CodeNova-X/PicoScout1/Images/PicoScout1-img1.png

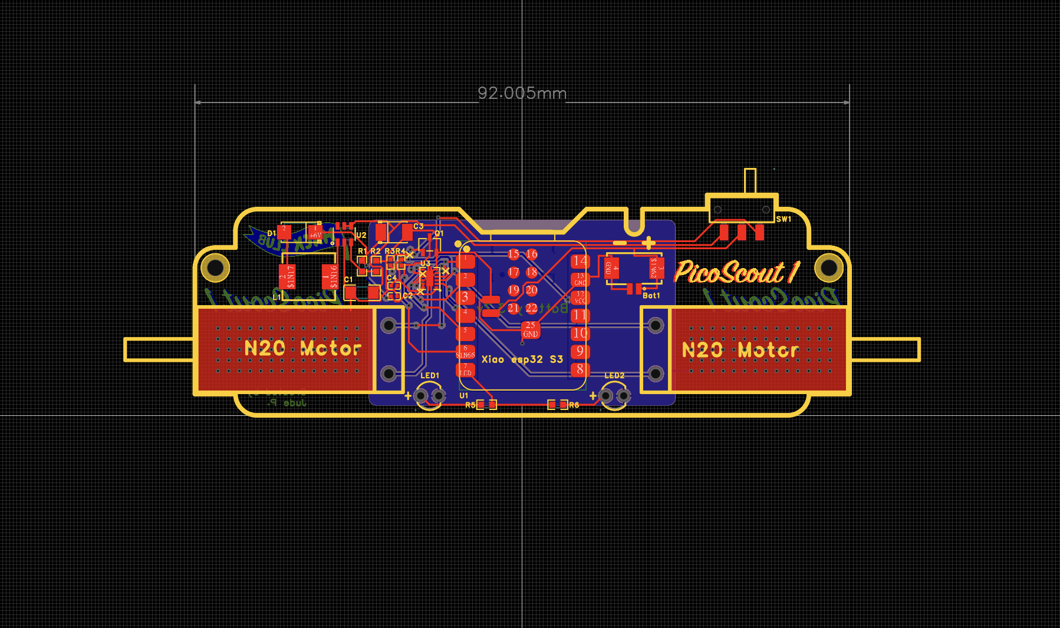
Images/PicoScout1-img1.png
