CodeNova-X/PicoScout1/Images/PicoScout1-img2.png

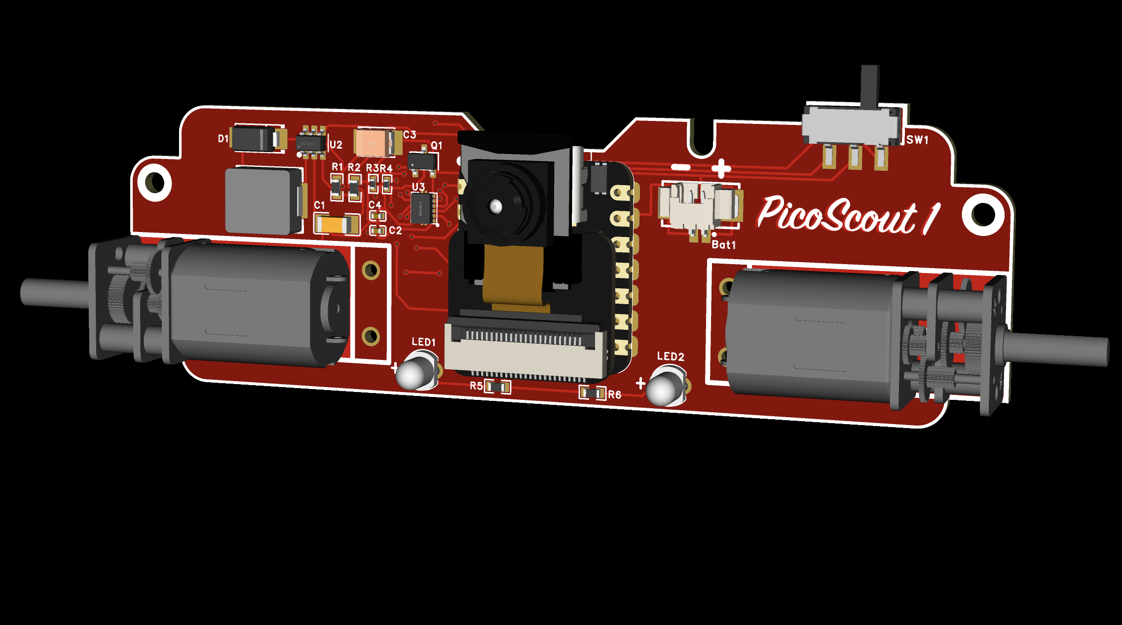
Images/PicoScout1-img2.png
