CodeNova-X/PicoScout1/Images/PicoScout1-img3.png

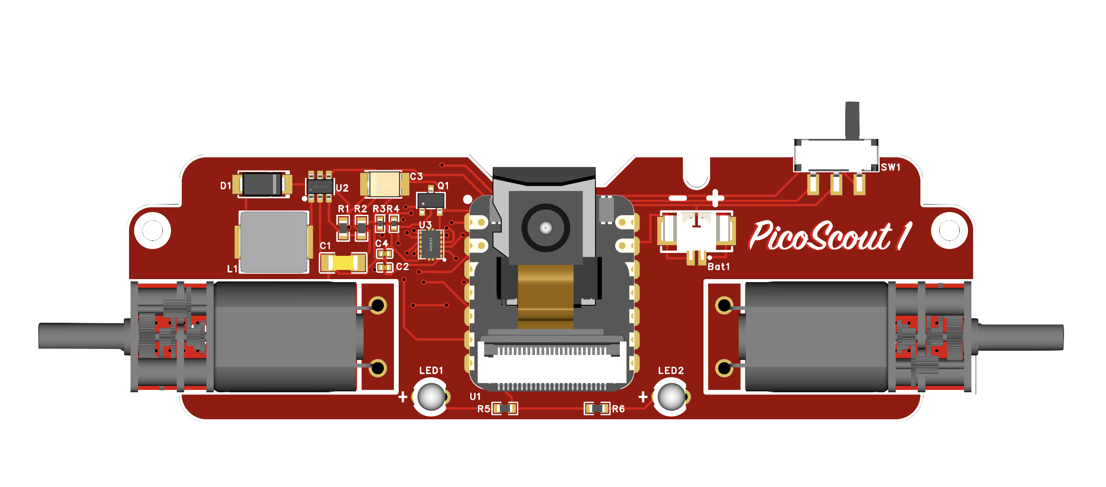
Images/PicoScout1-img3.png
