CodeNova-X/PicoScout1/Images/PicoScout1-img4.png

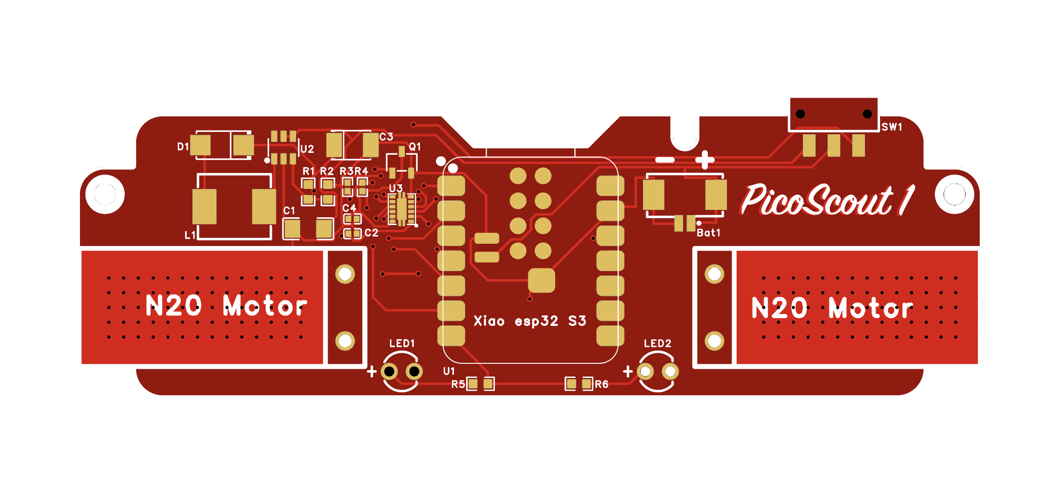
Images/PicoScout1-img4.png
