CodeNova-X/PicoScout1/Images/PicoScout1-img5.png

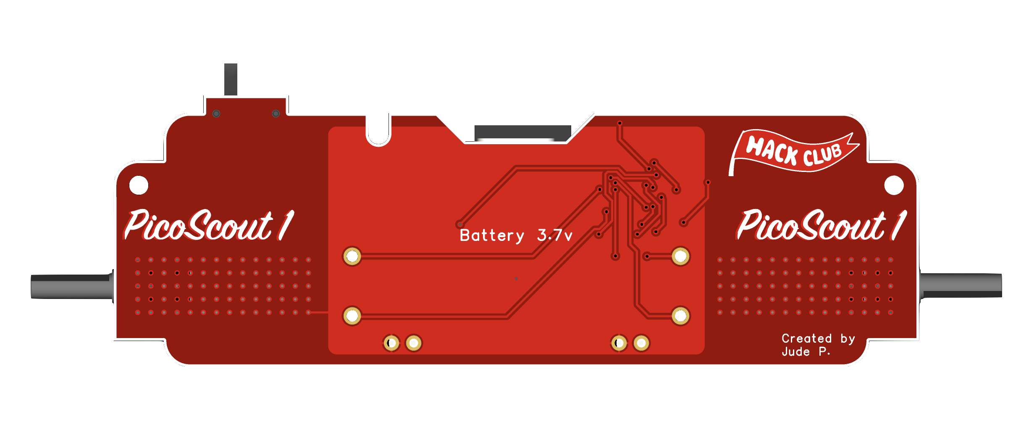
Images/PicoScout1-img5.png
