CodeNova-X/PicoScout1/BOM/PICOSCOUT1-BOM.csv

Name | Purpose | Cost/item | Quantity | Total cost (USD) | Link | Distributor
Molex 532610271 battery connector [Bat1] | PCB component (assembled by PCBWay) | 0.175 | 1 | 0.175 | https://www.lcsc.com/product-detail/C177225.html | PCBWay / LCSC
22uF 1206 capacitor (Samsung CL31A226KAHNNNE) [C1] | PCB component (assembled by PCBWay) | 3.171 | 1 | 3.171 | https://www.lcsc.com/product-detail/C12891.html | PCBWay / LCSC
100nF 0402 capacitor (Yageo CC0402KRX7R7BB104) [C2, C4] | PCB component (assembled by PCBWay) | 0.067 | 2 | 0.134 | https://www.lcsc.com/product-detail/C60474.html | PCBWay / LCSC
100uF case-B tantalum capacitor (KEMET T491B107K010AT) [C3] | PCB component (assembled by PCBWay) | 1.357 | 1 | 1.357 | https://www.lcsc.com/product-detail/C122271.html | PCBWay / LCSC
SS34 Schottky diode [D1] | PCB component (assembled by PCBWay) | 0.037 | 1 | 0.037 | https://www.lcsc.com/product-detail/C52023881.html | PCBWay / LCSC
22uH inductor (SRG0630-220-M) for boost converter [L1] | PCB component (assembled by PCBWay) | 0.273 | 1 | 0.273 | https://www.lcsc.com/product-detail/C53462993.html | PCBWay / LCSC
White through-hole LED (204-15UTC/S400-X9) [LED1, LED2] | PCB component (assembled by PCBWay) | 0.404 | 2 | 0.808 | https://www.lcsc.com/product-detail/C2892756.html | PCBWay / LCSC
MMBT3904 NPN transistor [Q1] | PCB component (assembled by PCBWay) | 0.474 | 1 | 0.474 | https://www.lcsc.com/product-detail/C55258612.html | PCBWay / LCSC
90.9k 0603 resistor [R1] | PCB component (assembled by PCBWay) | 0.088 | 1 | 0.088 | https://www.lcsc.com/product-detail/C269515.html | PCBWay / LCSC
10k 0603 resistor [R2] | PCB component (assembled by PCBWay) | 0.057 | 1 | 0.057 | https://www.lcsc.com/product-detail/C25804.html | PCBWay / LCSC
100k 0402 resistor [R3, R4] | PCB component (assembled by PCBWay) | 0.018 | 2 | 0.036 | https://www.lcsc.com/product-detail/C102750.html | PCBWay / LCSC
330 ohm 0603 resistor [R5, R6] | PCB component (assembled by PCBWay) | 0.062 | 2 | 0.124 | https://www.lcsc.com/product-detail/C105881.html | PCBWay / LCSC
SPDT slide switch (MST-12D18G4) [SW1] | PCB component (assembled by PCBWay) | 0.514 | 1 | 0.514 | https://www.lcsc.com/product-detail/C49023767.html | PCBWay / LCSC
MT3608 boost converter [U2] | PCB component (assembled by PCBWay) | 0.089 | 1 | 0.089 | https://www.lcsc.com/product-detail/C84817.html | PCBWay / LCSC
DRV8835 dual motor driver [U3] | PCB component (assembled by PCBWay) | 2.274 | 1 | 2.274 | https://www.lcsc.com/product-detail/C129328.html | PCBWay / LCSC
Seeed Studio XIAO ESP32-S3 Sense [U1] (ALREADY OWNED) | Main microcontroller with camera; already owned, not in order, value shown for reference | 21.73 | 1 | 21.73 | https://www.seeedstudio.com/XIAO-ESP32S3-Sense-p-5639.html | Seeed Studio
Custom 2-layer PCB 92x31mm 1.6mm HASL (5 pcs) | Main PCB | 5.0 | 1 | 5.0 | https://www.pcbway.com | PCBWay
PCBWay assembly fee | SMT assembly of PCB components | 29.0 | 1 | 29.0 | https://www.pcbway.com | PCBWay
PCBWay shipping | Shipping for PCB + assembly order | 33.62 | 1 | 33.62 | https://www.pcbway.com | PCBWay
PCBWay order discount (Winter Sale free shipping) | Discount | -29.69 | 1 | -29.69 | https://www.pcbway.com | PCBWay
PCBWay bank handling fee | Payment fee | 3.66 | 1 | 3.66 | https://www.pcbway.com | PCBWay
PCBWay duty & tax | Import duty and tax | 20.22 | 1 | 20.22 | https://www.pcbway.com | PCBWay
PCBWay DTP service fee | Service fee | 7.0 | 1 | 7.0 | https://www.pcbway.com | PCBWay
N20 motors (pack of 4; 2 needed) | Drive motors | 12.99 | 1 | 12.99 | https://www.amazon.com/dp/B0DK7635XH | Amazon
Amazon shipping (N20 motors) | Free shipping | 0.0 | 1 | 0.0 | https://www.amazon.com/dp/B0DK7635XH | Amazon
Estimated sales tax (N20 motors) | Estimated 8.9% Atlanta, GA rate on $12.99 | 1.16 | 1 | 1.16 | https://www.amazon.com/dp/B0DK7635XH | Amazon
3.7V 1000mAh 102050 LiPo battery (1 of 10-pack; other 9 for other projects) | Battery power source | 2.80 | 1 | 2.80 | https://ydlbattery.com/products/3-7v-1000mah-102050-lithium-polymer-ion-battery?variant=42093651787929 | YDL Battery
TOTAL (excluding owned XIAO) |  |  |  | 95.37
TOTAL (including owned XIAO) |  |  |  | 117.10
