CodeNova-X/PicoScout1/PicoScout1 Schematic.dxf

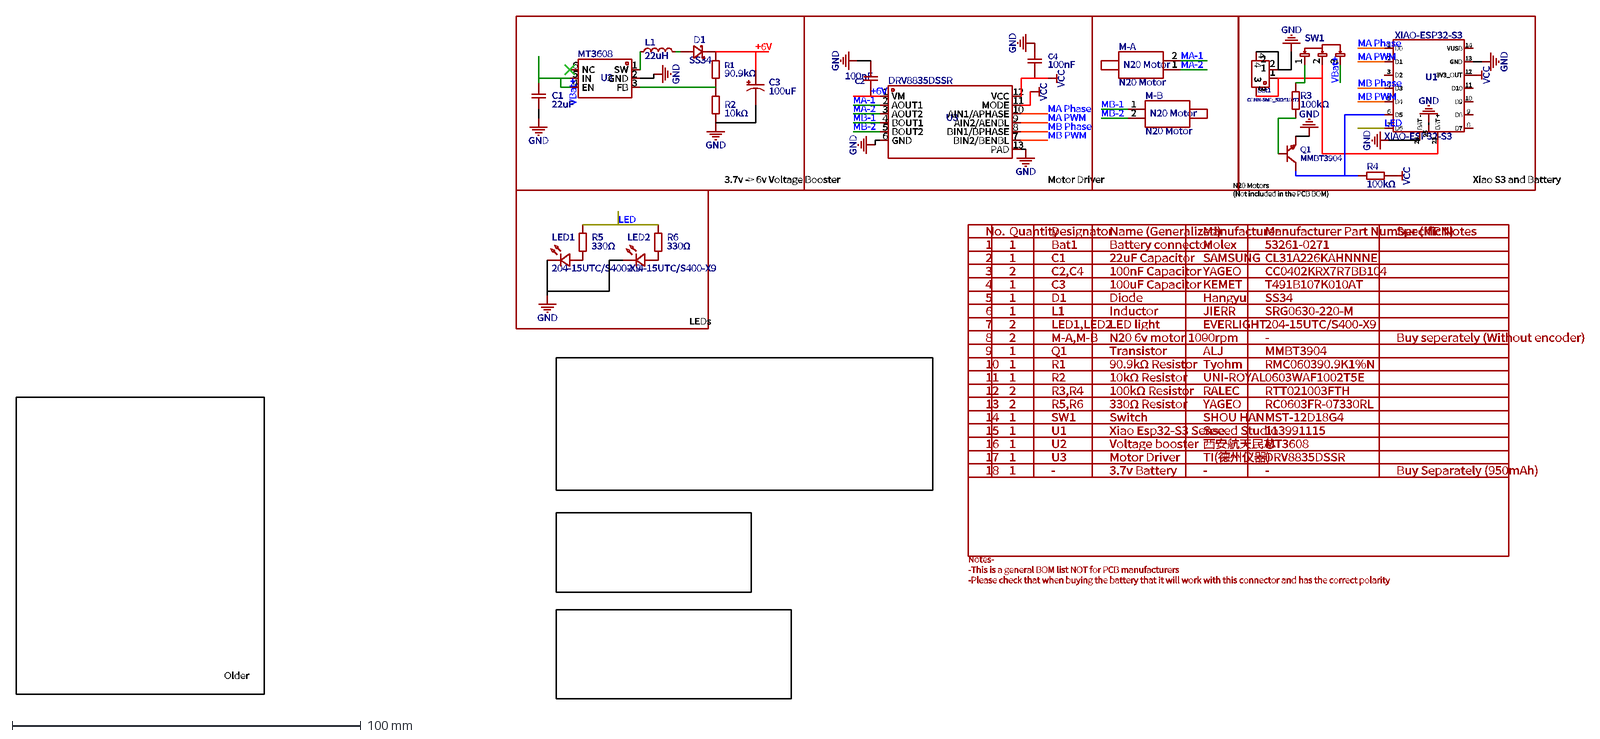
[picture p6: CAD file, 2026-10-11, last stored version]
PicoScout1 Schematic.dxf
N20 Motor
M-A
1
2
M-B
XIAO-ESP32-S3
U1
VUSB
14
GND
13
3V3_OUT
12
D10
11
D9
10
D8
9
D7
8
D6
7
D5
6
D4
5
D3
4
D2
3
D1
D0
BAT -
24
BAT +
23
25
Bat1
CONN-SMD_532610271
SW1
U2
MT3608
SW
FB
EN
IN
NC
SS34
C1
22uF
R1
90.9kΩ
R2
10kΩ
C3
100uF
3.7v -> 6v Voltage Booster
U3
DRV8835DSSR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
