CodeNova-X/PicoScout1/PCB files/PicoScout1_Schematic_2026-10-11.pdf

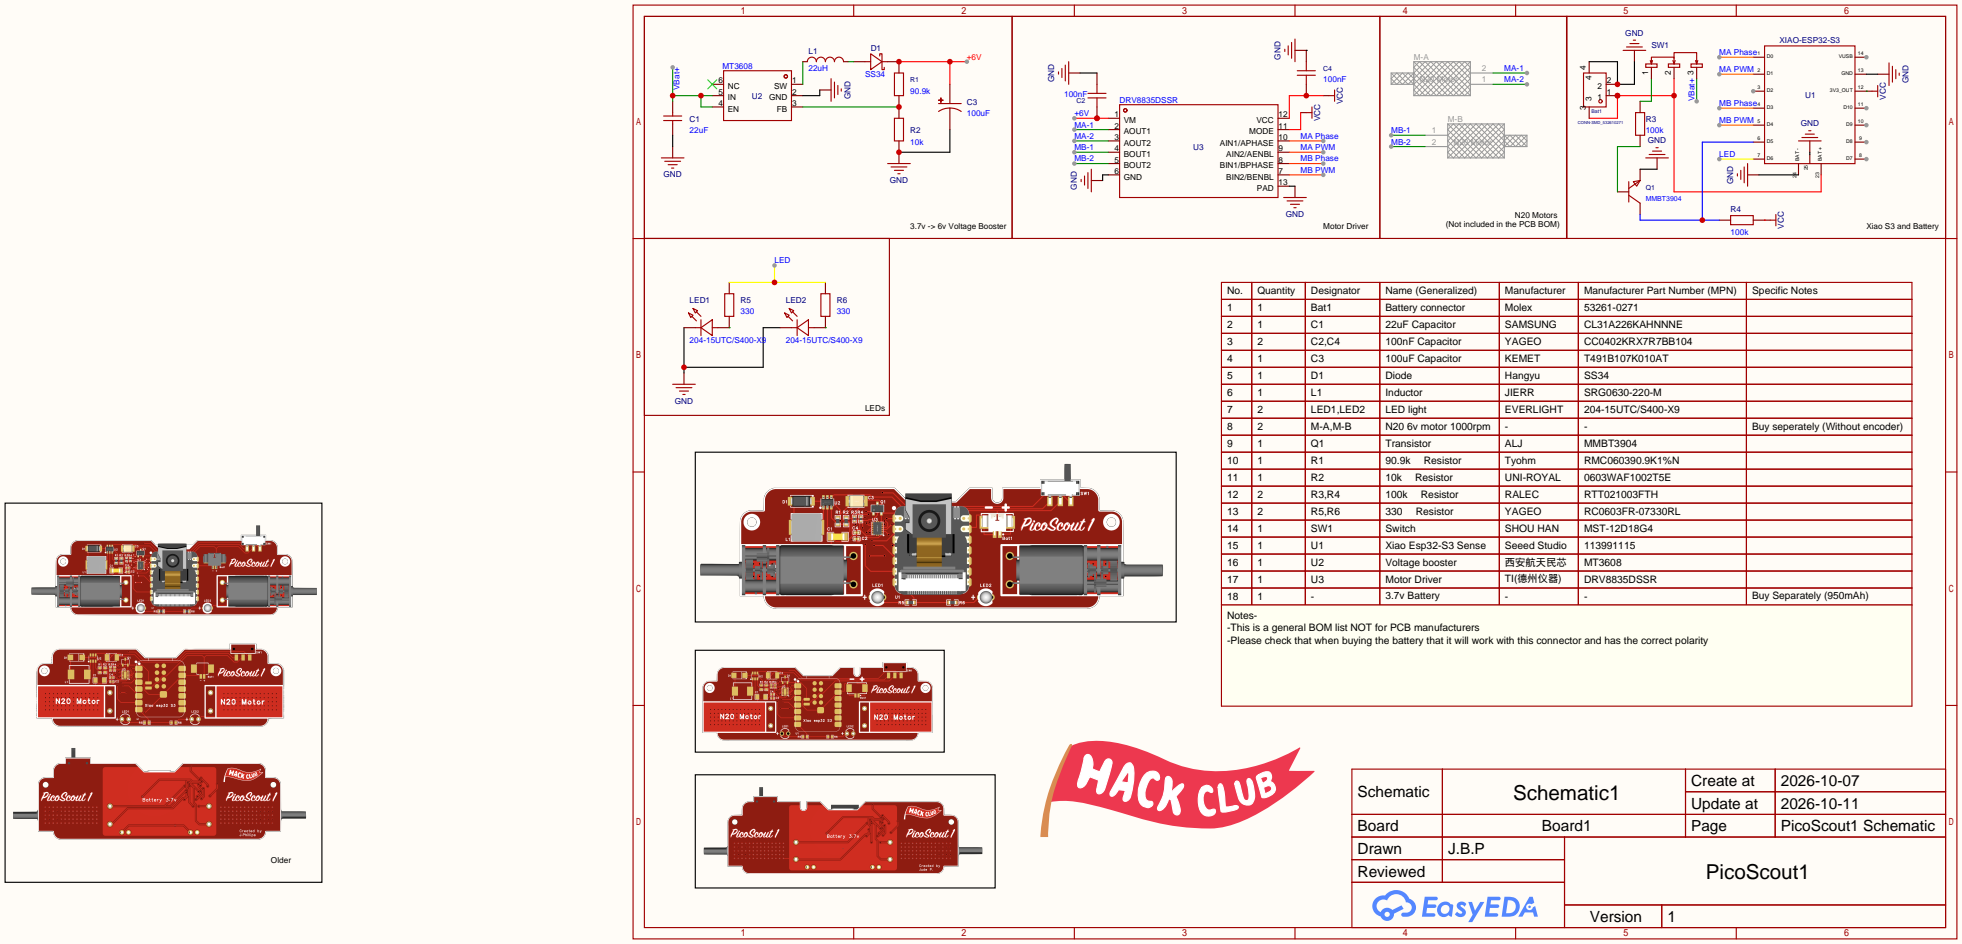
[picture p7: page 1]

No. | Quantity | Designator | Name (Generalized) | Manufacturer | Manufacturer Part Number (MPN) | Specific Notes
1 | 1 | Bat1 | Battery connector | Molex | 53261-0271
2 | 1 | C1 | 22uF Capacitor | SAMSUNG | CL31A226KAHNNNE
3 | 2 | C2,C4 | 100nF Capacitor | YAGEO | CC0402KRX7R7BB104
4 | 1 | C3 | 100uF Capacitor | KEMET | T491B107K010AT
5 | 1 | D1 | Diode | Hangyu | SS34
6 | 1 | L1 | Inductor | JIERR | SRG0630-220-M
7 | 2 | LED1,LED2 | LED light | EVERLIGHT | 204-15UTC/S400-X9
8 | 2 | M-A,M-B | N20 6v motor 1000rpm | - | - | Buy seperately (Without encoder)
9 | 1 | Q1 | Transistor | ALJ | MMBT3904
10 | 1 | R1 | 90.9k Resistor | Tyohm | RMC060390.9K1%N
11 | 1 | R2 | 10k Resistor | UNI-ROYAL | 0603WAF1002T5E
12 | 2 | R3,R4 | 100k Resistor | RALEC | RTT021003FTH
13 | 2 | R5,R6 | 330 Resistor | YAGEO | RC0603FR-07330RL
14 | 1 | SW1 | Switch | SHOU HAN | MST-12D18G4
15 | 1 | U1 | Xiao Esp32-S3 Sense | Seeed Studio | 113991115
16 | 1 | U2 | Voltage booster | 西安航天民芯 | MT3608
17 | 1 | U3 | Motor Driver | TI(德州仪器) | DRV8835DSSR
18 | 1 | - | 3.7v Battery | - | - | Buy Separately (950mAh)

Notes-
-This is a general BOM list NOT for PCB manufacturers
-Please check that when buying the battery that it will work with this connector and has the correct polarity

Schematic | Schematic1 | Create at | 2026-10-07

Update at | 2026-10-11

Board | Board1 | Page | PicoScout1 Schematic
Drawn | J.B.P | PicoScout1
Reviewed
