CodeNova-X/PicoScout1/Hack Club Journal/JOURNAL.md

# PicoScout1: devlog

<!-- Generated by Half Life from project cmv1fwo3v004k01ppriojg42n. Edits here are overwritten on the next sync. -->
<!-- Generated: 2026-10-11T22:54:12.609Z -->

> [!NOTE]
> This devlog is mirrored from [Half Life](https://halflife.hackclub.com) ([open the project](https://halflife.hackclub.com/projects/cmv1fwo3v004k01ppriojg42n)). Editing it here will not change the platform's copy, and the next sync overwrites this file.

> •  A two-wheeled camera robot you can control with your phone.•   For the longest time I have wanted to create a remote-controlled car of some sort. Once I found out that with Half Club/Half-Life can help fund projects I went to work to brainstorm. My hope is that this can help me create a prototype for a two wheeled bot with which I can make for a local  tech I help host at my small school during the summer and if I can get this to work I would be really excited.   PicoScout1 is not just any robot but I wanted a small robot that can be good to use for tech camp or anyone really but my plan is to make it so that I can control it with a phone and be able to move the robot and see what the camera sees which can make for some fun for really anyone to play with *If it works*. This is my first project with Hack Club but it will not be my first but second PCB I designed yet motors will be a new thing for me. Also Week 1 ends up also being when I have a break off of school so I can devote more time upfront.

| Week | Tier | Hours logged | Entries |
| --- | --- | --- | --- |
| Week 1 | Tier 3 | 31.53h | 6 |

## Contents

1. [2026-10-10: Monday-Wednesday of Week 1](#2026-10-10-monday-wednesday-of-week-1)
2. [2026-10-10: -Thursday](#2026-10-10--thursday)
3. [2026-10-10: Thursday](#2026-10-10-thursday)
4. [2026-10-10: Friday](#2026-10-10-friday)
5. [2026-10-10: Saturday](#2026-10-10-saturday)
6. [2026-10-11: Work session](#2026-10-11-work-session)

## Design

### 2026-10-10: Monday-Wednesday of Week 1

**9h**

Monday-Wednesday of Week 1

  IMG_09369L9QLx

IMG_09358zrASb

   I did a lot of research trying to figure out what parts to use for my PicoScout1. I ended up deciding that N20 motors are my best bet for this project and I was going to use the Xiao esp32 S3 for the camera and to control the robot. I used EasyEDA which I have used for 1 other PCB project but there were so many things I still did not know. I spent multiple hours just trying to import components into EasyEDA which they do not have in their list of components like the motors and the xiao esp32 S3.

Screenshot 2026-10-10 at 4.02.18 PM
I found this project on https://hackaday.io/project/175378-3d-printable-antweight-battlebot-bulldog/details along with other projects like Micromouse but this one in particular was the one that encouraged me to use the N20 motors for my project.

IMG_0934HWAyH6

 I started on my first design and something happened and it got messed up so it disappeared but I did print the design of what I had at one point which I have.  I thought I could make a two PCB sandwich with the motors and the battery in the center.

   However that is not the design I stuck with but I decided for a 2 wheel approach on the pcb with the idea being that it will go inside a 3d printed case. I had AI help me with how to wire some of these parts and find them for me because I had no prior knowledge of how to make a 3.7 to 6v boost converter which I added and the motor controller for the two wheels.

Screenshot 2026-10-10 at 2.40.10 PM
This is the voltage booster in my schematic

Screenshot 2026-10-10 at 2.40.20 PM
This one is my motor driver

Screenshot 2026-10-10 at 2.40.33 PM
This one is the 2 N20 motors (I had to design a custom footprint and everything because EasyEDA did not have it.

Screenshot 2026-10-10 at 3.18.25 PM


I found this schematic online and it helped me with the footprint and getting the right size because I do not have it yet.

Ok, I know that was a lot to talk about for one journal entry but I wanted to have something to share before I started actually sharing stuff about it. Also this is my first Hack Club thing so I am new to how this works. ; )

### 2026-10-10: -Thursday

**5h**

-Thursday

   I continued working on PicoScout1. I added the xiao and some of its wiring and I started a little but on the pcb and kept moving stuff around on my board to fit the minimal space I had. I still was not sure about the design so I also did a lot of research about capacitors and resistors to use and I have to admit I had AI help me with some of my questions. One of the things I kept wondering was if I should let the Battery be able to charge through the xiao esp32 S3 and eventually I decided that to have the switch off will disconnect the battery from everything but the xiao so it can charge and I have a few components that in theory should let the xiao know to go to deep sleep mode if the switch was turned off.

Motor driver schematic
I used AI to help me brainstorm because I did not want to create a project that will not work so the image above is me asking it how to make sure that the xiao will know if the switch was on or not. That was just a snippet, I had other component questions as well like what type of leds I should use.

Screenshot 2026-10-10 at 4.38.45 PM

Screenshot 2026-10-10 at 4.38.56 PM

Screenshot 2026-10-10 at 4.39.19 PM

Transistor Switch Diagram

### 2026-10-10: Thursday

**5.5h**

Thursday

IMG_0932nNI3Za

I actually have the start of my PCB!  It took me a while to figure out how to create a more complex shape in
EasyEDA, I did a lot of routing to fit all the components like the resistors and capacitors and such. I created a simple battery 3d shell as a mockup of what it would be and the LEDs I have are special to point 90 degrees.

Screenshot 2026-10-10 at 5.02.52 PM
This is a close up of the Components. *Note- I designed this so that all the components are actually on the top of the pcb except for the battery which does not have to be on the bottom.





Screenshot 2026-10-10 at 5.12.38 PM
The full schematic so far

I almost forgot to mention, I also worked on some deco and added PicoScout on the board yet I still have some more ideas for the board like adding holes for screws

IMG_0938g5hFSQ

Screenshot 2026-10-10 at 5.33.02 PM

### 2026-10-10: Friday

**5h**

Friday

I worked on finishing the design of my PCB and I made my Schematic look nicer to make it easier for others to understand. I ended up choosing different leds instead of the fancy 90 degree ones because those are more expensive  and I thought that using through whole leds would allow for more customization where the light is pointing to. I moved the motors out more and I changed some of the routing and added some holes under the motors for the heat to dissipate in theory (don’t know if it is needed or not but I thought it would be a good thing to add) I added some screw holes and I made notch to make it easier to plug in a usb. Since I kind of got the hang of the project and the base of it was mainly there, I just added a lot of small adjustments. I also added a BOM on the schematic and I am pretty sure it is accurate but and cannot say with 100% because I individually  typed or pasted in each box in the chart with some oversight of some AI to make sure it was right but mainly from the BOM from EasyEDA but the issue is that some of the parts were custom components into EasyEDA so that is why.

Screenshot 2026-10-10 at 5.18.09 PM

Screenshot 2026-10-10 at 5.18.24 PM

Screenshot 2026-10-10 at 5.18.30 PM

PicoScoutBoard-TopView

PicoScoutBoard-TopView2

Screenshot 2026-10-09 at 1.30.47 PM

Screenshot 2026-10-09 at 10.29.59 AM

### 2026-10-10: Saturday

**5h**

Saturday

I created my GitHub Repo and added a few things, not fully done though but it took me a while because it was my first time using GitHub to create my own repo and I learned that you need special notation I guess you can say to be able to just add an indention in a readme.md. I created a banner for the Github repo. Then I worked on finishing all of my entries for the week because all the other days, it would be too late to add what I did and I was too focused on the project.

PicoScout1-Banner

This is the banner I made for the Github

Screenshot 2026-10-10 at 5.57.37 PM

Me trying to create a readme.md with actual space between lines. ( I don’t understand why it has to be this way😵‍💫)
Screenshot 2026-10-10 at 5.52.55 PM

Screenshot 2026-10-10 at 5.56.58 PM

Me creating some reels because I have not been thinking about making a reel or posting until today
Screenshot 2026-10-10 at 5.57.24 PM

I did not realize It was going to take so many images to document all of this and this is just a snippet 🤯😮‍💨😵‍💫
Screenshot 2026-10-10 at 5.59.02 PM

### 2026-10-11: Work session

**2.03h**

[Timelapse](https://lookout.hackclub.com/api/media/d8713fd0-60f0-4e59-ab9b-f81ce084d2c2/video.mp4)
