CodeNova-X/PicoScout1/(commit log)

2026-10-10 Added PicoScout Schematic
    Includes Schematic, Images, and BOM, all of which may change in the future.
2026-10-10 Added images of the PicoScout 1 Board
2026-10-10 added pcb image
2026-10-10 Added Gerber file
2026-10-11 Delete Gerber_PicoScout1_2026-10-10.zip
    Old version
2026-10-11 Added PCB files
    [BOM_PicoScout1_2026-10-11.csv, PickAndPlace_PicoScout1_2026_10_11.xlsx]
2026-10-11 trying to find the file that half life accepts
    [PicoScout1 Schematic.dxf]
2026-10-11 Delete PicoScout1 Schematic.dxf
    did not work
    [PicoScout1 Schematic.dxf]
2026-10-11 Added updated schematic
2026-10-11 Delete PicoScout1_Schematic_2026-10-09.pdf
    remove old schematic
2026-10-12 Add blank test.kicad_pcb file
    hopefully this works for half life to accept the project
    [test.kicad_pcb]
2026-10-19 Sync PicoScout1 Body from Half Life
    [BOM.csv]
2026-11-10 Sync PicoScout1 from Half Life
    [BOM.csv]
2026-11-10 Add BOM
    [PICOSCOUT1-BOM.csv]
2026-11-10 Add headers to PICOSCOUT1-BOM.csv
    Updated the BOM file to include headers and retain existing component details.
    [PICOSCOUT1-BOM.csv]
2026-11-10 Update BOM with new cost structure and items
    [PICOSCOUT1-BOM.csv]
2026-11-10 Update BOM with new components and revised totals
    Added new components including a LiPo battery and updated totals.
    [PICOSCOUT1-BOM.csv]
2026-11-10 Add arduino test code file
    may not work
    [PicoScout1_Test.ino]
2026-11-10 Organize files to folders
    [BOM.csv, PICOSCOUT1-BOM.csv, PickAndPlace_PicoScout1_2026_10_11.xlsx]
